nadasaidani63/labpilot/labpilot/hardware/README.md

# Hardware

- `cad/`: STL / DXF / STEP files of the printed and laser-cut parts
- Wiring diagram: add `wiring_diagram.png`
- Bill of materials: add `bill_of_materials.md` (the materials request document can be reused)
