nadasaidani63/labpilot/labpilot/firmware/README.md

# Arduino firmware

Put `LabPilot.ino` here. Keep the pin map in a comment at the top of the sketch:

- Stepper: CNC Shield V3, X axis
- HX711: A0 (data) / A1 (clock)
- End-stop: D9
