nadasaidani63/labpilot/labpilot/software/README.md

# Raspberry Pi software

Put your Python files here (camera checks, protocol reader, serial link to the Arduino, logging).
Describe each file in one line below once they are uploaded.

| File | Role |
|---|---|
| _file.py_ | _what it does_ |
