nadasaidani63/labpilot/files (2)/labpilot_camera_tab.png

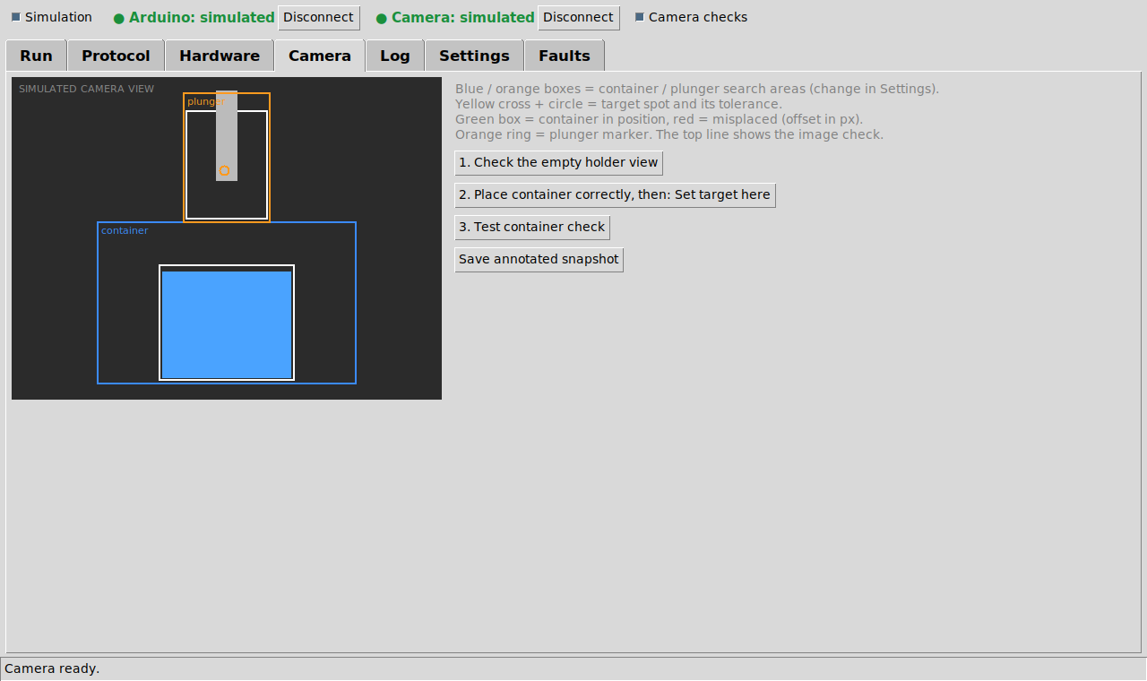
files (2)/labpilot_camera_tab.png
