nadasaidani63/labpilot/files (2)/labpilot_run_simulation.png

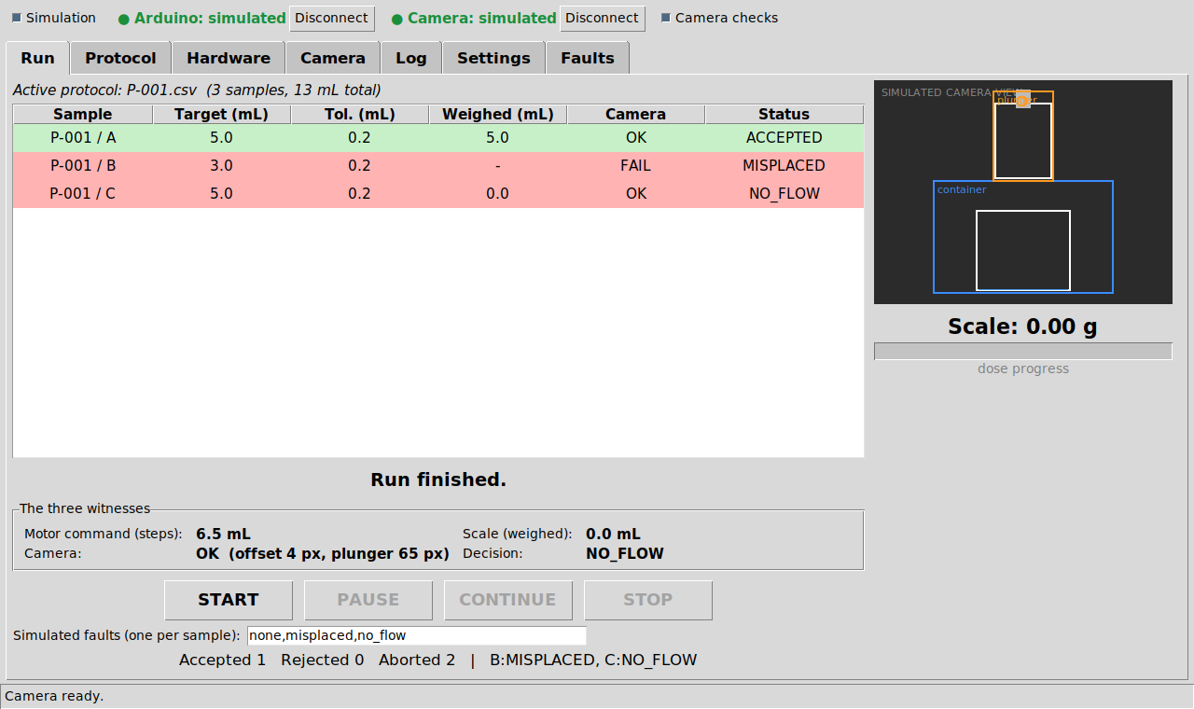
files (2)/labpilot_run_simulation.png
