nadasaidani63/labpilot/hardware.xlsx

Item name | Item Description | Items number | Link
Stepper motor | Nema 17 Stepper Motor (Bipolar, 40mm, 45Ncm) | 1 | https://tuni-smart-innovation.com/products/17hs4401-nema-17-moteur-pas-a-pas-1?_pos=1&_sid=5271d2ea2&_ss=r
acouplement | 5mm to 5mm Motor Shaft Coupling | 1 | https://www.celectronix.com/accesoires-imprimante-3d/4945-accouplement-lastique-5mm-5mm-d20-l25.html
Steel Rod | 6mm Steel Rod (length 200mm, pack of 2) | 1 | https://bricola.tn/goujon-et-tige-filetee-tunisie/34984-tige-filetee-galvanisee-l1000-x-diam6-mm-0702090002.html
roulement | 6mm Linear Bearing (roulement ) | 4 | https://seli.tn/product/roulements-a-mouvement-lineaire-standard/
tige filtée | M5x0.8 Threaded Rod (length 170mm) | 1 | should be designed specificly
nut | M5x0.8 nut | 1 | https://cothings.net/collections/ecrou/mecanique
vis | M3x0.5 socket head screws to mount motor (length 20mm) | 4 | https://cothings.net/collections/meilleures-ventes/products/vis-a-tete-cylindrique-a-six-pans-creux-en-acier-inoxydable-201-m3-20-mm
vis | M3x0.5 socket head screws (hold rod in place, length 10mm) | 2 | https://cothings.net/collections/meilleures-ventes/products/vis-a-tete-cylindrique-a-six-pans-creux-en-acier-inoxydable-201-m3-10-mm
nut | M3 nut (hold rod in place) | 2 | https://cothings.net/collections/ecrou/mecanique
SCREW_ KNOB M5 | M5 knob (hold syringe in place) | 1 | https://www.acs.tn/produit/screw_-knob-m5-s43485000/
power unit | 12V power unit (end stripped to fit CNC shield power input) | 1 | https://cothings.net/collections/alimentations-12v/alimentations-12v
cnc shield v3 | CNC Shield v3 | 1 | https://souilah-electronique.tn/prototypage/123-arduino-uno-cnc-shield-v3.html
Carte Raspberry Pi | Raspberry Pi 4 model b Motherboard | 1 | https://tuni-smart-innovation.com/collections/raspberry-1/products/kit-raspberry-pi-4-4gb
Camera | camera Raspberry | 1 | https://tuni-smart-innovation.com/products/camera-raspberry-5mp-rev-1-3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
touchscreen display | Raspberry Pi 7" touchscreen display | 1 | https://souilah-electronique.tn/modules-et-capteurs/1061-ecran-tactile-35-lcd-hdmi-pour-raspberry-pi-4.html
Raspberry pi power suppy | Raspberry Pi Power Suppy (5v 1.5A DC) | 1 | comes with raspberry kit
SD card | 16gb MicroSD card (comes with adapter) | 1 | https://www.mytek.tn/informatique/stockage/carte-memoire.html
screws | M3x0.5 Socket Head Screws (length 10mm) | 4 | https://cothings.net/collections/meilleures-ventes/products/vis-a-tete-cylindrique-a-six-pans-creux-en-acier-inoxydable-201-m3-10-mm
screws | M5x0.8 Socket Head Screw (length 14mm) | 8 | quincaillerie
nuts | M5x0.8 nuts | 8 | https://cothings.net/collections/ecrou/mecanique
arduino uno | Arduino uno | 1 | https://souilah-electronique.tn/cartes-de-developpement/26-arduino-uno-r3-atmega328p-dip16.html
