nadasaidani63/labpilot/files (2)/Smashing-Turing (1).stl

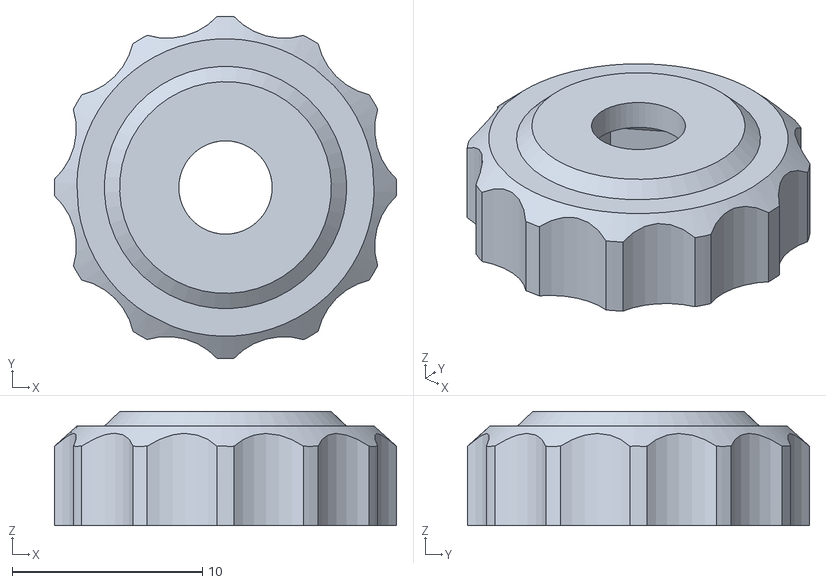
[picture p4: CAD file, 2026-11-07]
files (2)/Smashing-Turing (1).stl
18.0 x 18.0 x 6.00
