nadasaidani63/labpilot/Joytrainer mini 1.3 A0/output_page_01.dxf

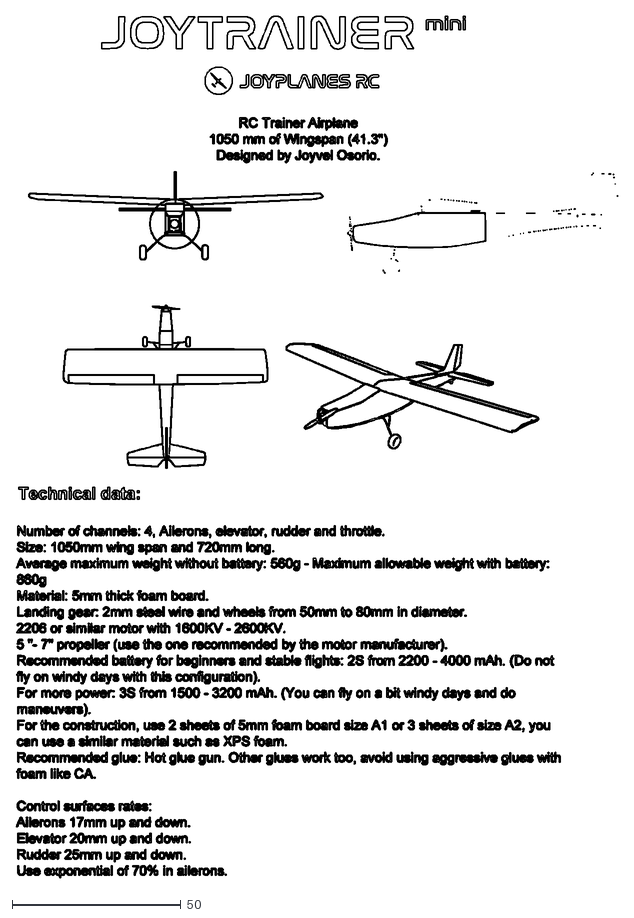
[picture p5: CAD file, 2026-11-07]
Joytrainer mini 1.3 A0/output_page_01.dxf
178.2 x 255.6
