nadasaidani63/labpilot/files (2)/Scope_Screen_Leg_Mount_v33.stl

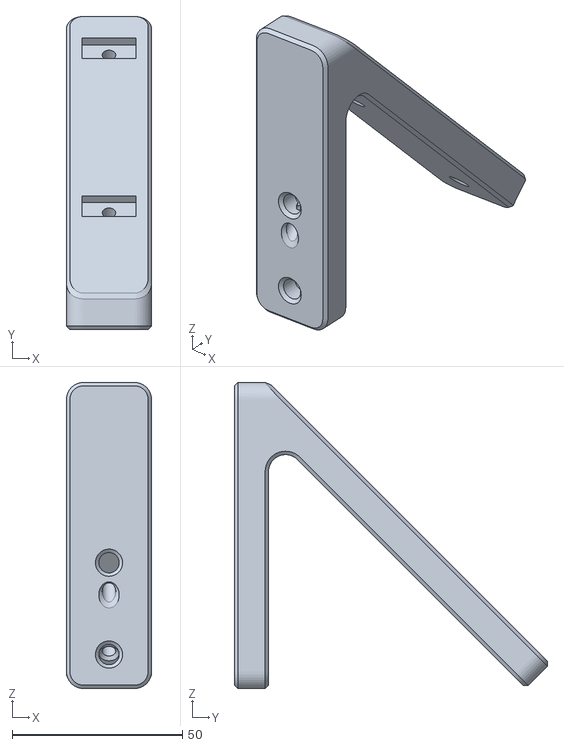
[picture p6: CAD file, 2026-11-07]
files (2)/Scope_Screen_Leg_Mount_v33.stl
25.0 x 92.0 x 90.0
