nadasaidani63/labpilot/Joytrainer mini 1.3 A0/output_page_02.dxf

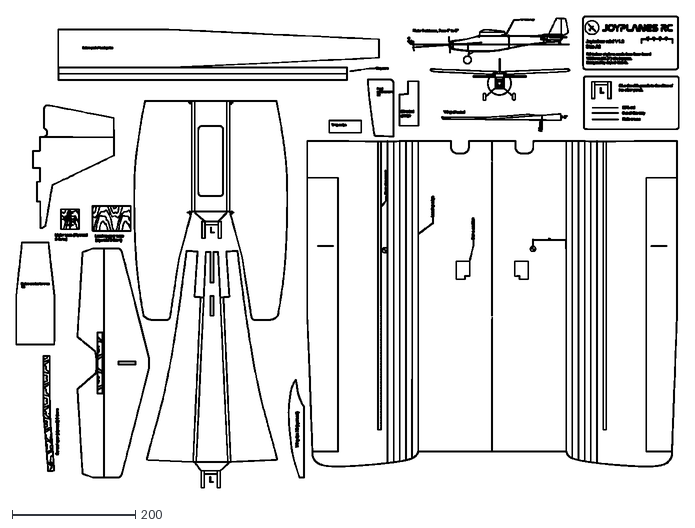
[picture p7: CAD file, 2026-11-07]
Joytrainer mini 1.3 A0/output_page_02.dxf
1077.5 x 766.5
