nadasaidani63/labpilot/files (2)/Ingenious Gaaris-Gogo (1).stl

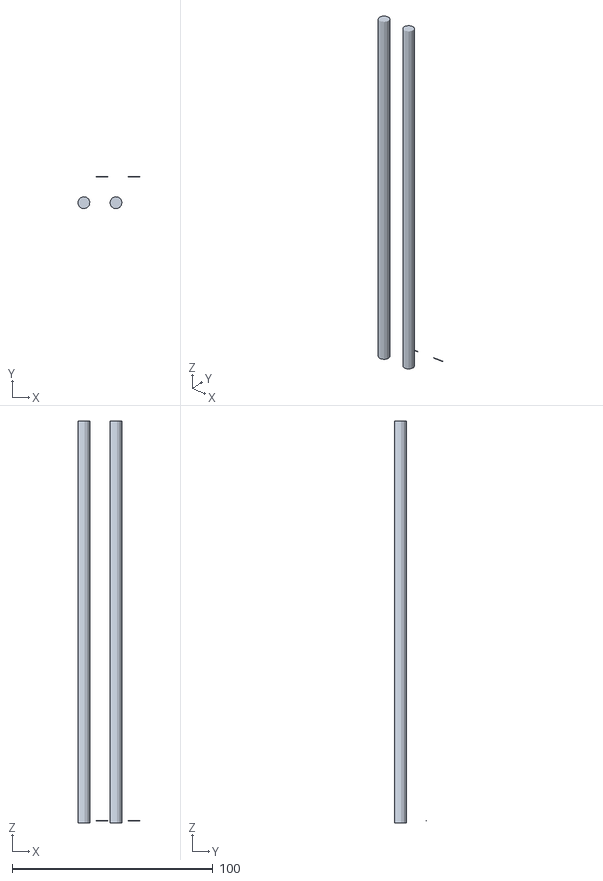
[picture p8: CAD file, 2026-11-07]
files (2)/Ingenious Gaaris-Gogo (1).stl
30.9 x 16.1 x 200.0
