nadasaidani63/labpilot/files (2)/labpilot_wiring.png

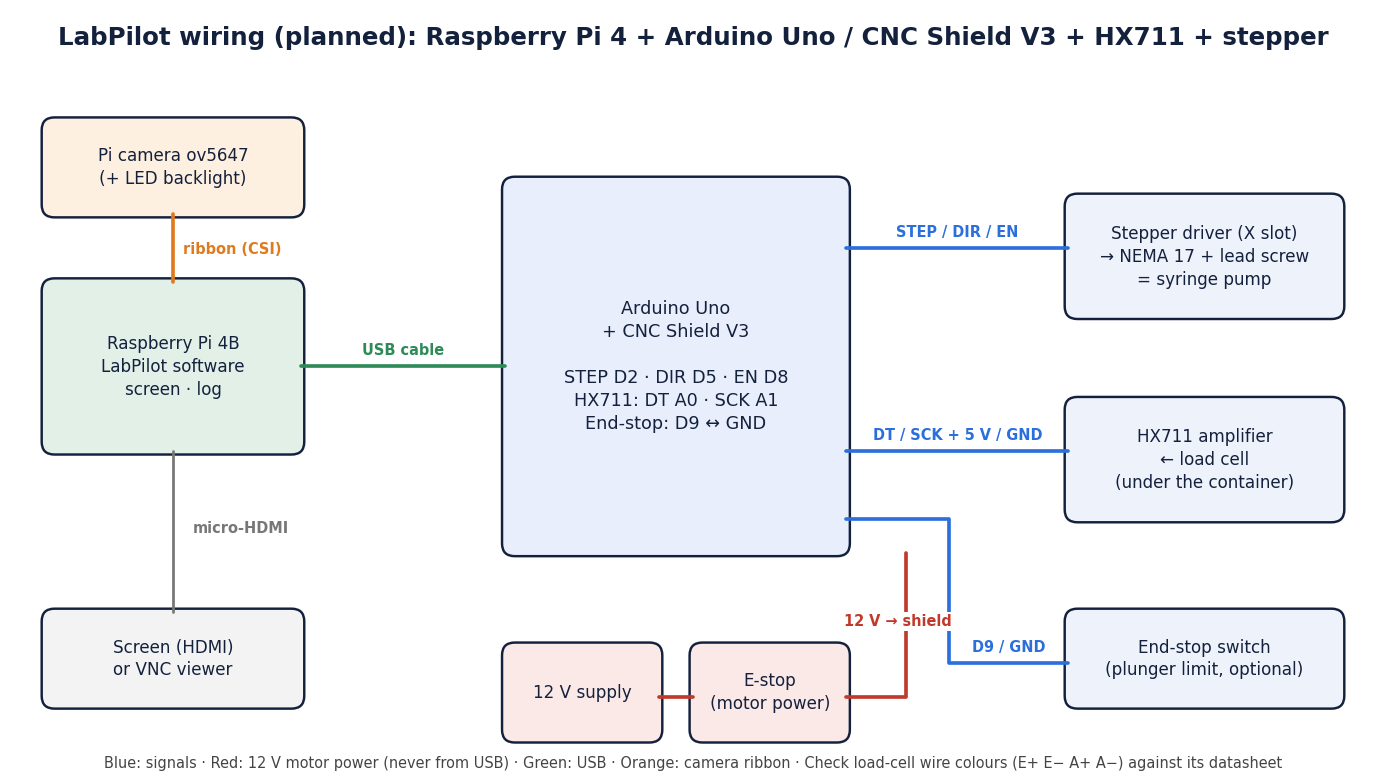
files (2)/labpilot_wiring.png
